icl-rocketry/Ricardo-Crosshair/Hardware/Main board.kicad_pcb

## KiCad design Hardware/Main board.kicad_pcb (2025-07-31)

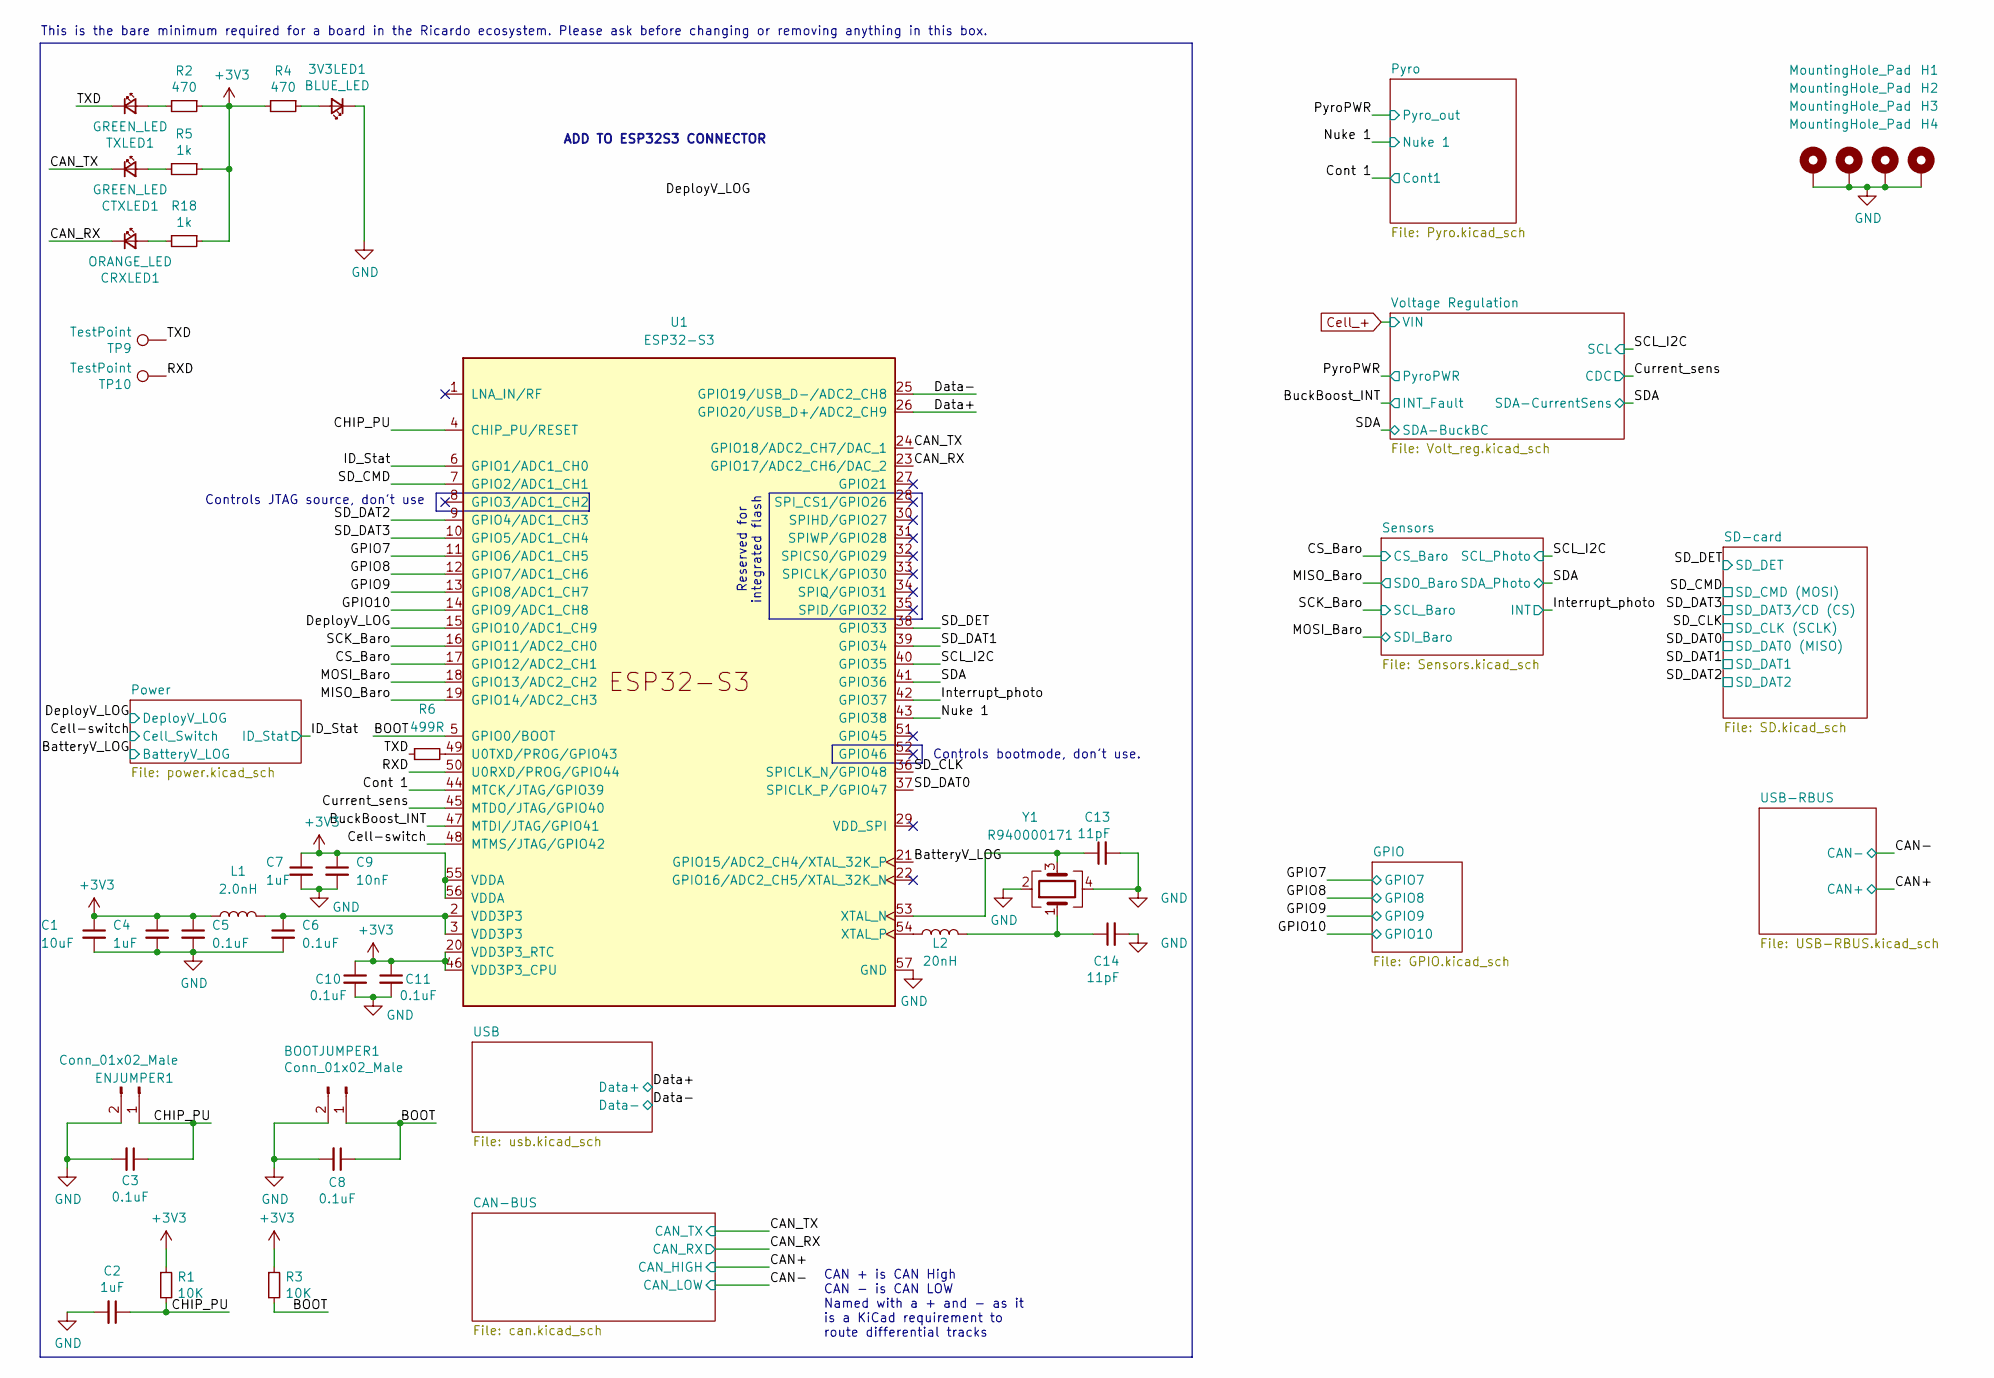
[picture p1: schematic Main board.kicad_sch]

Parts:
3V3LED1: BLUE_LED; LED_0402_1005Metric
BOOTJUMPER1: Conn_01x02_Male; PinHeader_1x02_P2.54mm_Vertical
C1: 10uF; C_0402_1005Metric
C2, C4, C7: 1uF; C_0402_1005Metric
C3, C5, C6, C8, C10, C11: 0.1uF; C_0402_1005Metric
C9: 10nF; C_0402_1005Metric
C13, C14: 11pF; C_0402_1005Metric
CRXLED1: ORANGE_LED; LED_0402_1005Metric
CTXLED1: GREEN_LED; LED_0402_1005Metric
ENJUMPER1: Conn_01x02_Male; PinHeader_1x02_P2.54mm_Vertical
H1, H2, H3, H4: MountingHole_Pad; MountingHole_3.2mm_M3_DIN965_Pad
L1: 2.0nH; L_0402_1005Metric
L2: 20nH; L_0402_1005Metric
R1, R3: 10K; R_0402_1005Metric
R2, R4: 470; R_0402_1005Metric
R5, R18: 1k; R_0402_1005Metric
R6: 499R; R_0402_1005Metric
TP9, TP10: TestPoint; TestPoint_Pad_D1.0mm
TXLED1: GREEN_LED; LED_0402_1005Metric
U1: ESP32-S3; QFN40P700X700X90-57N
Y1: R940000171; Crystal_SMD_2016-4Pin_2.0x1.6mm

Connections:
+3V3: C1.1, C4.1, C5.1, C7.1, C9.1, C10.1, C11.1, L1.1, R1.1, R2.1, R3.1, R4.2, R5.1, R18.1, U1.20 (VDD3P3_RTC), U1.46 (VDD3P3_CPU), U1.55 (VDDA), U1.56 (VDDA); also elsewhere on the board
/BOOT: BOOTJUMPER1.1, C8.1, R3.2, U1.5 (GPIO0/BOOT)
/BatteryV_LOG: U1.21 (GPIO15/ADC2_CH4/XTAL_32K_P); also elsewhere on the board
/BuckBoost_INT: U1.47 (MTDI/JTAG/GPIO41); also elsewhere on the board
/CAN_RX: CRXLED1.1 (K), U1.23 (GPIO17/ADC2_CH6/DAC_2); also elsewhere on the board
/CAN_TX: CTXLED1.1 (K), U1.24 (GPIO18/ADC2_CH7/DAC_1); also elsewhere on the board
/CHIP_PU: C2.1, C3.1, ENJUMPER1.1, R1.2, U1.4 (CHIP_PU/RESET)
/CS_Baro: U1.17 (GPIO12/ADC2_CH1); also elsewhere on the board
/Cell-switch: U1.48 (MTMS/JTAG/GPIO42); also elsewhere on the board
/Cont 1: U1.44 (MTCK/JTAG/GPIO39); also elsewhere on the board
/Current_sens: U1.45 (MTDO/JTAG/GPIO40); also elsewhere on the board
/Data+: U1.26 (GPIO20/USB_D+/ADC2_CH9); also elsewhere on the board
/Data-: U1.25 (GPIO19/USB_D-/ADC2_CH8); also elsewhere on the board
/DeployV_LOG: U1.15 (GPIO10/ADC1_CH9); also elsewhere on the board
/GPIO7: U1.11 (GPIO6/ADC1_CH5); also elsewhere on the board
/GPIO8: U1.12 (GPIO7/ADC1_CH6); also elsewhere on the board
/GPIO9: U1.13 (GPIO8/ADC1_CH7); also elsewhere on the board
/GPIO10: U1.14 (GPIO9/ADC1_CH8); also elsewhere on the board
/ID_Stat: U1.6 (GPIO1/ADC1_CH0); also elsewhere on the board
/Interrupt_photo: U1.42 (GPIO37); also elsewhere on the board
/MISO_Baro: U1.19 (GPIO14/ADC2_CH3); also elsewhere on the board
/MOSI_Baro: U1.18 (GPIO13/ADC2_CH2); also elsewhere on the board
/Nuke 1: U1.43 (GPIO38); also elsewhere on the board
/RXD: TP10.1, U1.50 (U0RXD/PROG/GPIO44)
/SCK_Baro: U1.16 (GPIO11/ADC2_CH0); also elsewhere on the board
/SCL_I2C: U1.40 (GPIO35); also elsewhere on the board
/SDA: U1.41 (GPIO36); also elsewhere on the board
/SD_CLK: U1.36 (SPICLK_N/GPIO48); also elsewhere on the board
/SD_CMD: U1.7 (GPIO2/ADC1_CH1); also elsewhere on the board
/SD_DAT0: U1.37 (SPICLK_P/GPIO47); also elsewhere on the board
/SD_DAT1: U1.39 (GPIO34); also elsewhere on the board
/SD_DAT2: U1.9 (GPIO4/ADC1_CH3); also elsewhere on the board
/SD_DAT3: U1.10 (GPIO5/ADC1_CH4); also elsewhere on the board
/SD_DET: U1.38 (GPIO33); also elsewhere on the board
/TXD: R6.1, TP9.1, TXLED1.1 (K)
GND: 3V3LED1.1 (K), BOOTJUMPER1.2, C1.2, C2.2, C3.2, C4.2, C5.2, C6.2, C7.2, C8.2, C9.2, C10.2, C11.2, C13.2, C14.2, ENJUMPER1.2, H1.1, H2.1, H3.1, H4.1, U1.57 (GND), Y1.2, Y1.4; also elsewhere on the board
unnamed: 3V3LED1.2 (A), R4.1
unnamed: C6.1, L1.2, U1.2 (VDD3P3), U1.3 (VDD3P3)
unnamed: C14.1, L2.2, Y1.1
unnamed: CRXLED1.2 (A), R18.2
unnamed: CTXLED1.2 (A), R5.2
unnamed: R2.2, TXLED1.2 (A)
unnamed: R6.2, U1.49 (U0TXD/PROG/GPIO43)
unnamed: C13.1, U1.53 (XTAL_N), Y1.3
unnamed: L2.1, U1.54 (XTAL_P)

Notes on the sheet:
Controls bootmode, don't use.
This is the bare minimum required for a board in the Ricardo ecosystem. Please ask before changing or removing anything in this box.
CAN + is CAN High CAN - is CAN LOW Named with a + and - as it is a KiCad requirement to route differential tracks
Controls JTAG source, don't use
ADD TO ESP32S3 CONNECTOR
Reserved for integrated flash

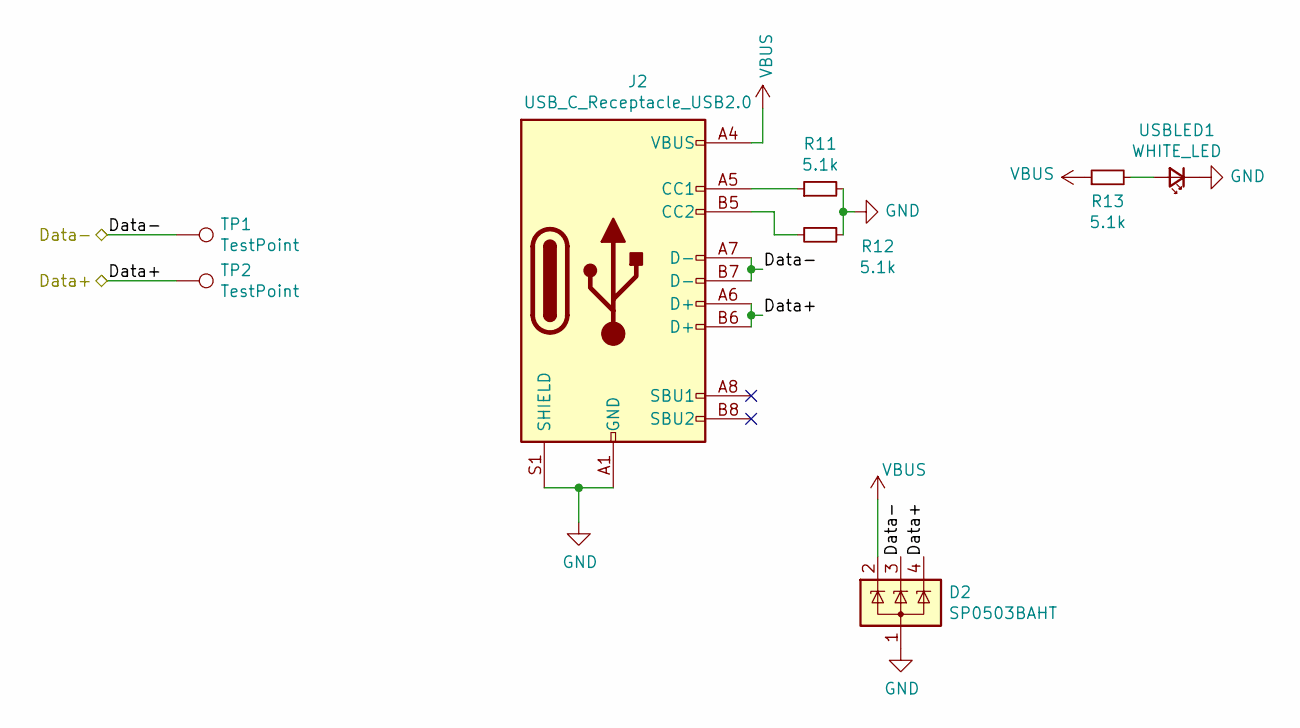
[picture p2: schematic usb.kicad_sch]

Parts:
D2: SP0503BAHT; SOT-143
J2: USB_C_Receptacle_USB2.0; USB_C_Receptacle_Palconn_UTC16-G
R11, R12, R13: 5.1k; R_0402_1005Metric
TP1, TP2: TestPoint; TestPoint_Pad_D1.0mm
USBLED1: WHITE_LED; LED_0402_1005Metric

Connections:
/Data+: D2.4 (K), J2.A6 (D+), J2.B6 (D+), TP2.1; also elsewhere on the board
/Data-: D2.3 (K), J2.A7 (D-), J2.B7 (D-), TP1.1; also elsewhere on the board
GND: D2.1 (A), J2.A1 (GND), J2.A12 (GND), J2.B1 (GND), J2.B12 (GND), J2.S1 (SHIELD), R11.2, R12.1, USBLED1.1 (K); also elsewhere on the board
unnamed: J2.A5 (CC1), R11.1
unnamed: J2.B5 (CC2), R12.2
unnamed: R13.2, USBLED1.2 (A)
VBUS: D2.2 (K), J2.A4 (VBUS), J2.A9 (VBUS), J2.B4 (VBUS), J2.B9 (VBUS), R13.1; also elsewhere on the board

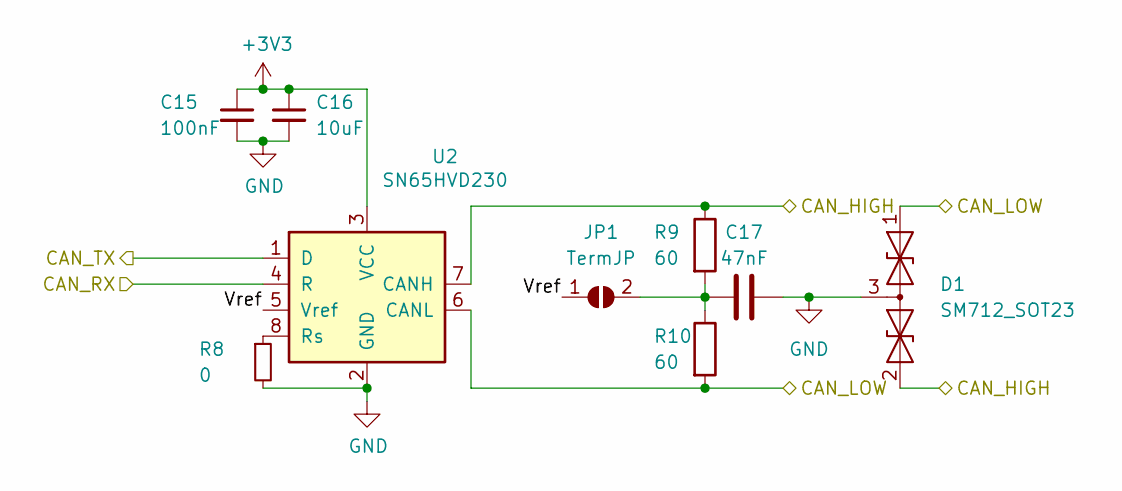
[picture p3: schematic can.kicad_sch]

Parts:
C15: 100nF; C_0402_1005Metric
C16: 10uF; C_0402_1005Metric
C17: 47nF; C_0402_1005Metric
D1: SM712_SOT23; SOT-23
JP1: TermJP; SolderJumper-2_P1.3mm_Open_RoundedPad1.0x1.5mm
R8: 0; R_0603_1608Metric
R9, R10: 60; R_0603_1608Metric
U2: SN65HVD230; SOIC-8_3.9x4.9mm_P1.27mm

Connections:
+3V3: C15.1, C16.1, U2.3 (VCC); also elsewhere on the board
/CAN+: D1.2 (A2), R9.1, U2.7 (CANH); also elsewhere on the board
/CAN-: D1.1 (A1), R10.2, U2.6 (CANL); also elsewhere on the board
/CAN-BUS/Vref: JP1.1 (A), U2.5 (Vref)
/CAN_RX: U2.4 (R); also elsewhere on the board
/CAN_TX: U2.1 (D); also elsewhere on the board
GND: C15.2, C16.2, C17.2, D1.3 (common), R8.2, U2.2 (GND); also elsewhere on the board
unnamed: C17.1, JP1.2 (B), R9.2, R10.1
unnamed: R8.1, U2.8 (Rs)

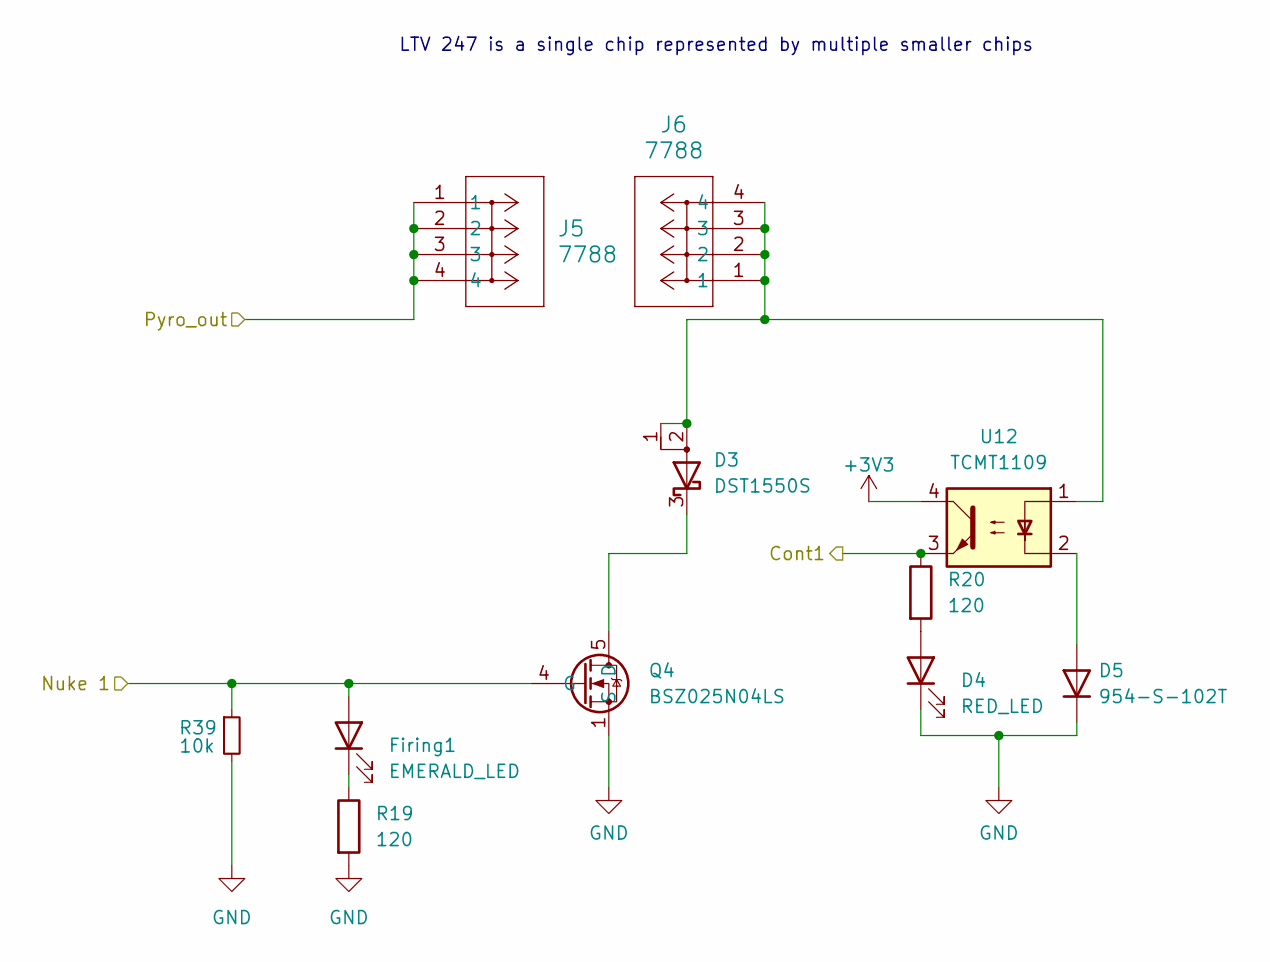
[picture p4: schematic Pyro.kicad_sch]

Parts:
D3: DST1550S; TO-277B
D4: RED_LED; LED_0603_1608Metric
D5: 954-S-102T; D_1206_3216Metric
Firing1: EMERALD_LED; LED_0402_1005Metric
J5, J6: 7788; CONN_7788_KEY
Q4: BSZ025N04LS; Manufacturer_Part_Number BSZ025N04LS; Mouser Part Number 726-BSZ025N04LS
R19: 120; R_0402_1005Metric
R20: 120; R_0603_1608Metric
R39: 10k; R_0402_1005Metric
U12: TCMT1109; SOP-4_4.4x2.6mm_P1.27mm

Connections:
+3V3: U12.4; also elsewhere on the board
/Cont 1: R20.1, U12.3; also elsewhere on the board
/Nuke 1: Firing1.2 (A), Q4.4 (G), R39.1; also elsewhere on the board
/PyroPWR: J5.1, J5.2, J5.3, J5.4; also elsewhere on the board
GND: D4.1 (K), D5.1 (K), Q4.1 (S), Q4.2 (S), Q4.3 (S), Q4.A1 (S), R19.2, R39.2; also elsewhere on the board
unnamed: D3.1 (A), D3.2 (A), J6.1, J6.2, J6.3, J6.4, U12.1
unnamed: D3.3 (K), Q4.5 (D), Q4.6 (D), Q4.7 (D), Q4.8 (D), Q4.A5 (D)
unnamed: D4.2 (A), R20.2
unnamed: D5.2 (A), U12.2
unnamed: Firing1.1 (K), R19.1

Notes on the sheet:
LTV 247 is a single chip represented by multiple smaller chips

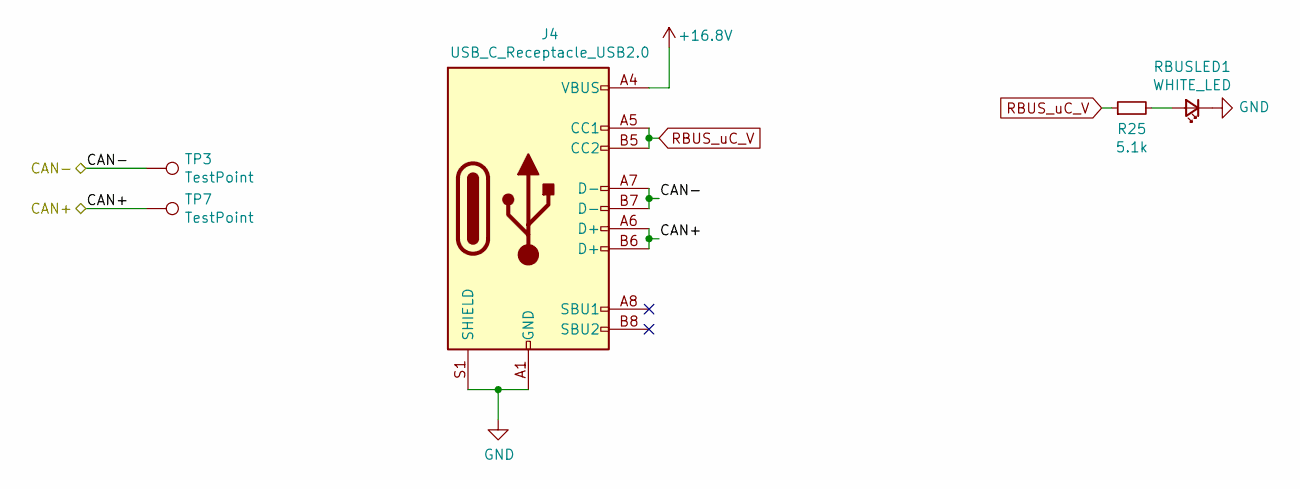
[picture p5: schematic USB-RBUS.kicad_sch]

Parts:
J4: USB_C_Receptacle_USB2.0; USB_C_Receptacle_Palconn_UTC16-G
R25: 5.1k; R_0402_1005Metric
RBUSLED1: WHITE_LED; LED_0402_1005Metric
TP3, TP7: TestPoint; TestPoint_Pad_D1.0mm

Connections:
+16.8V: J4.A4 (VBUS), J4.A9 (VBUS), J4.B4 (VBUS), J4.B9 (VBUS); also elsewhere on the board
/CAN+: J4.A6 (D+), J4.B6 (D+), TP7.1; also elsewhere on the board
/CAN-: J4.A7 (D-), J4.B7 (D-), TP3.1; also elsewhere on the board
GND: J4.A1 (GND), J4.A12 (GND), J4.B1 (GND), J4.B12 (GND), J4.S1 (SHIELD), RBUSLED1.1 (K); also elsewhere on the board
unnamed: R25.2, RBUSLED1.2 (A)
RBUS_uC_V: J4.A5 (CC1), J4.B5 (CC2), R25.1; also elsewhere on the board

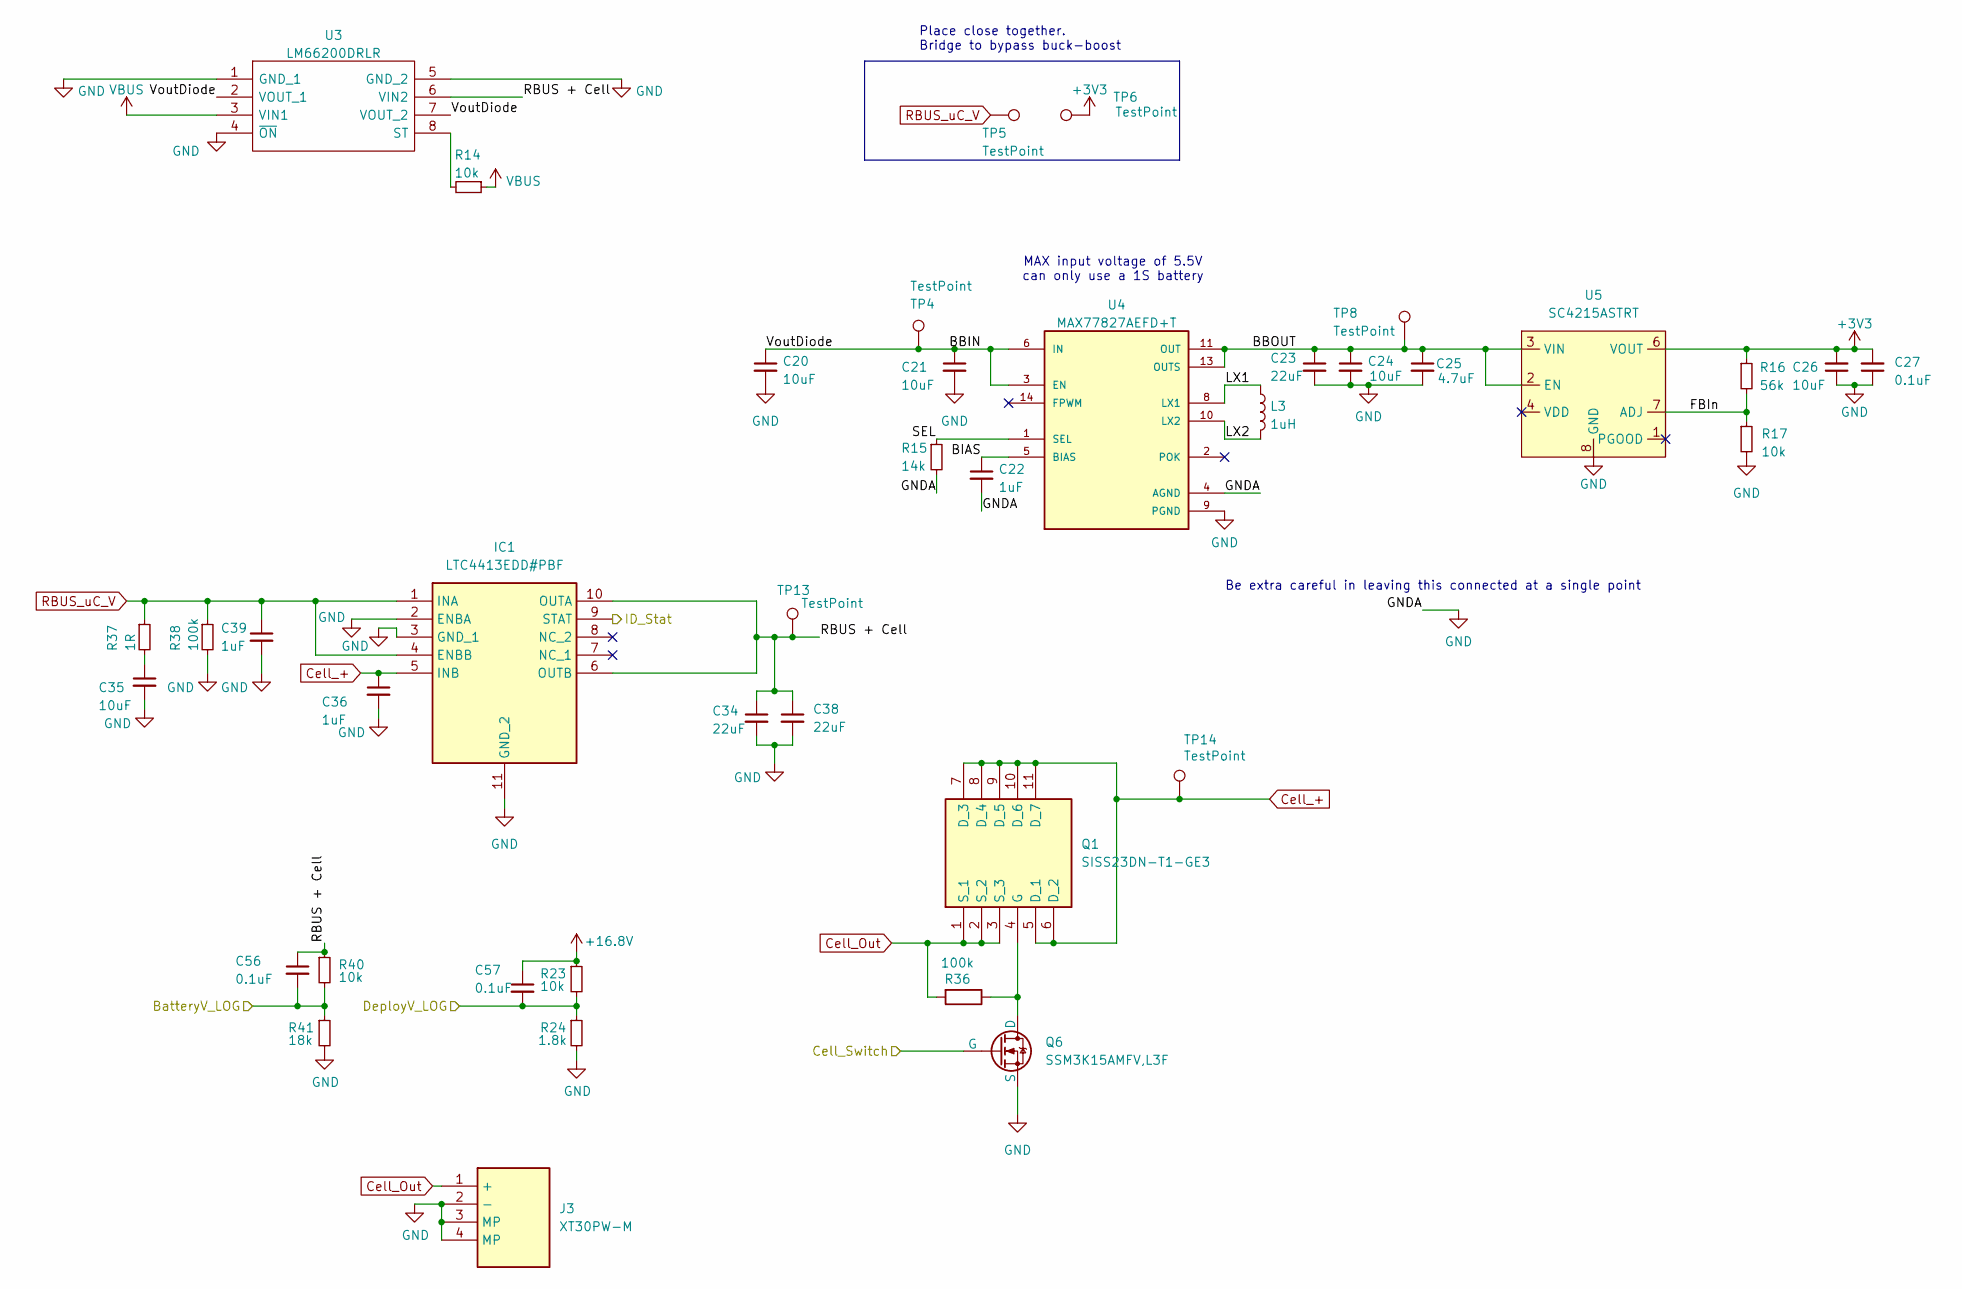
[picture p6: schematic power.kicad_sch]

Parts:
C20, C24, C26, C35: 10uF; C_0402_1005Metric
C21: 10uF; C_0603_1608Metric
C22, C36, C39: 1uF; C_0402_1005Metric
C23: 22uF; C_0603_1608Metric
C25: 4.7uF; C_0402_1005Metric
C27, C56, C57: 0.1uF; C_0402_1005Metric
C34, C38: 22uF; C_0402_1005Metric
IC1: LTC4413EDD#PBF; SON50P300X300X80-11N-D; Mouser Part Number 584-LTC4413EDD#PBF
J3: XT30PW-M; XT30PWM; Manufacturer_Part_Number XT30PW-M
L3: 1uH; L_0805_2012Metric
Q1: SISS23DN-T1-GE3; SQS850ENT1_GE3; Mouser Part Number 78-SISS23DN-T1-GE3
Q6: SSM3K15AMFV,L3F; SOT-723
R14, R17, R23, R40: 10k; R_0402_1005Metric
R15: 14k; R_0402_1005Metric
R16: 56k; R_0402_1005Metric
R24: 1.8k; R_0402_1005Metric
R36, R38: 100k; R_0402_1005Metric
R37: 1R; R_0402_1005Metric
R41: 18k; R_0402_1005Metric
TP4, TP5, TP6, TP8, TP14: TestPoint; TestPoint_Pad_D1.5mm
TP13: TestPoint; TestPoint_Pad_D1.0mm
U3: LM66200DRLR; SOTFL50P160X60-8N; Manufacturer_Part_Number LM66200DRLR; Mouser Part Number 595-LM66200DRLR
U4: MAX77827AEFD+T; CONV_MAX77827AEFD+T; PARTREV B
U5: SC4215ASTRT; SOIC127P599X175-9N

Connections:
+3V3: C26.2, C27.2, R16.1, TP6.1, U5.6 (VOUT); also elsewhere on the board
+16.8V: C57.1, R23.1; also elsewhere on the board
/BatteryV_LOG: C56.2, R40.2, R41.1; also elsewhere on the board
/Cell-switch: Q6.2 (G); also elsewhere on the board
/DeployV_LOG: C57.2, R23.2, R24.1; also elsewhere on the board
/ID_Stat: IC1.9 (STAT); also elsewhere on the board
/Power/BBIN: C20.1, C21.1, TP4.1, U3.2 (VOUT_1), U3.7 (VOUT_2), U4.3 (EN), U4.6 (IN)
/Power/BBOUT: C23.1, C24.1, C25.1, TP8.1, U4.11 (OUT), U4.13 (OUTS), U5.2 (EN), U5.3 (VIN)
/Power/BIAS: C22.1, U4.5 (BIAS)
/Power/FBIn: R16.2, R17.1, U5.7 (ADJ)
/Power/LX1: L3.1, U4.8 (LX1)
/Power/LX2: L3.2, U4.10 (LX2)
/Power/RBUS + Cell: C34.1, C38.1, C56.1, IC1.6 (OUTB), IC1.10 (OUTA), R40.1, TP13.1, U3.6 (VIN2)
/Power/SEL: R15.1, U4.1 (SEL)
Cell_+: C36.1, IC1.5 (INB), Q1.5 (D_1), Q1.6 (D_2), Q1.7 (D_3), Q1.8 (D_4), Q1.9 (D_5), Q1.10 (D_6), Q1.11 (D_7), TP14.1; also elsewhere on the board
Cell_Out: J3.1 (+), Q1.1 (S_1), Q1.2 (S_2), Q1.3 (S_3), R36.2
GND: C20.2, C21.2, C22.2, C23.2, C24.2, C25.2, C26.1, C27.1, C34.2, C35.2, C36.2, C38.2, C39.2, IC1.2 (ENBA), IC1.3 (GND_1), IC1.11 (GND_2), J3.2 (-), J3.3 (MP), J3.4 (MP), Q6.3 (S), R15.2, R17.2, R24.2, R38.2, R41.2, U3.1 (GND_1), U3.4 (~ON), U3.5 (GND_2), U4.4 (AGND), U4.9 (PGND), U5.8 (GND), U5.9 (GND); also elsewhere on the board
unnamed: C35.1, R37.2
unnamed: Q1.4 (G), Q6.1 (D), R36.1
unnamed: R14.2, U3.8 (ST)
RBUS_uC_V: C39.1, IC1.1 (INA), IC1.4 (ENBB), R37.1, R38.1, TP5.1; also elsewhere on the board
VBUS: R14.1, U3.3 (VIN1); also elsewhere on the board

Notes on the sheet:
Place close together. Bridge to bypass buck-boost
MAX input voltage of 5.5V can only use a 1S battery
Be extra careful in leaving this connected at a single point

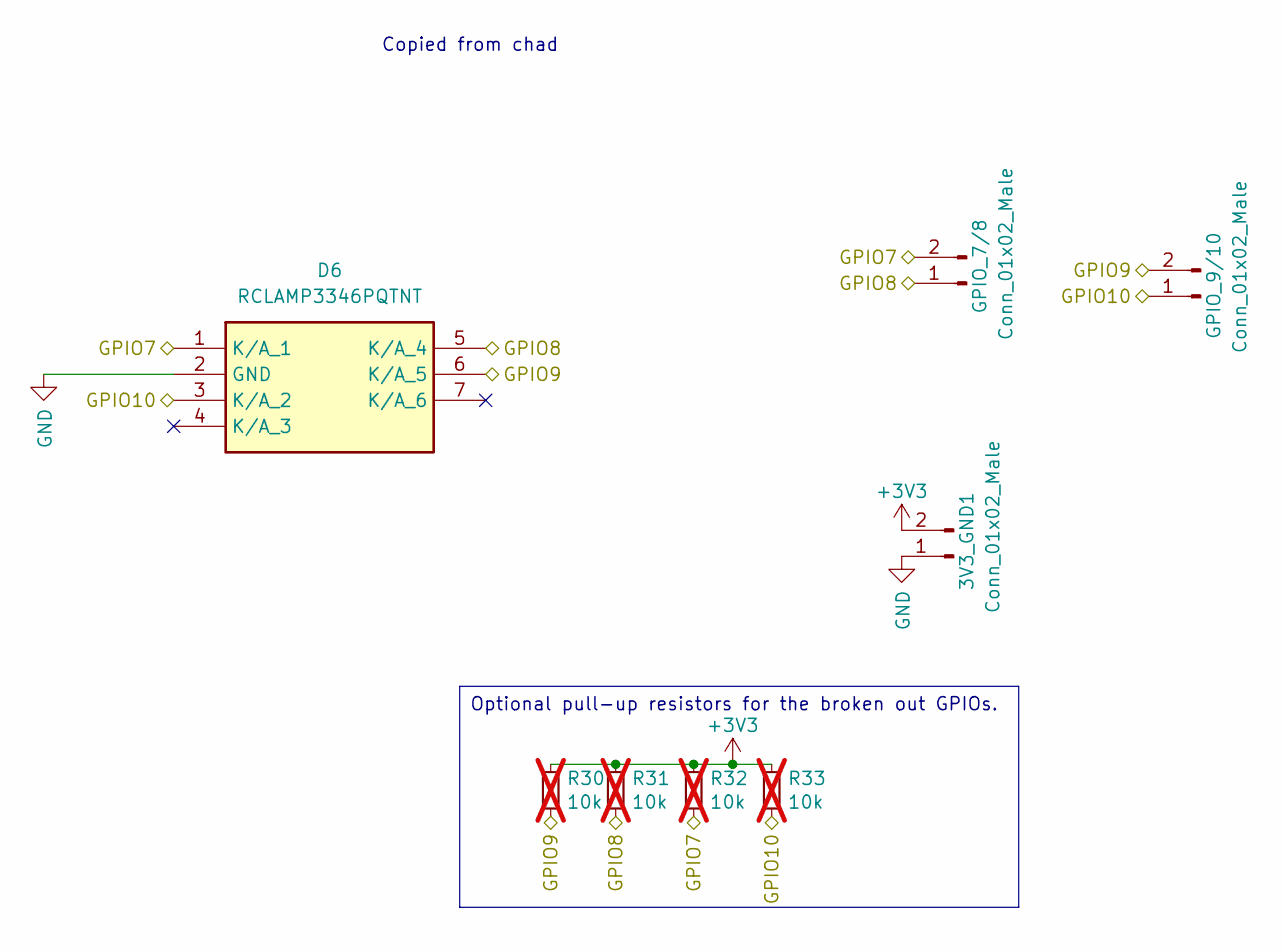
[picture p7: schematic GPIO.kicad_sch]

Parts:
3V3_GND1: Conn_01x02_Male; PinHeader_1x02_P2.54mm_Vertical
D6: RCLAMP3346PQTNT; Mouser Part Number 947-RCLAMP3346PQTNT
GPIO_7/8, GPIO_9/10: Conn_01x02_Male; PinHeader_1x02_P2.54mm_Vertical
R30, R31, R32, R33: 10k; R_0402_1005Metric; not fitted

Connections:
+3V3: 3V3_GND1.2, R30.1, R31.1, R32.1, R33.1; also elsewhere on the board
/GPIO7: D6.1 (K/A_1), GPIO_7/8.2, R32.2; also elsewhere on the board
/GPIO8: D6.5 (K/A_4), GPIO_7/8.1, R31.2; also elsewhere on the board
/GPIO9: D6.6 (K/A_5), GPIO_9/10.2, R30.2; also elsewhere on the board
/GPIO10: D6.3 (K/A_2), GPIO_9/10.1, R33.2; also elsewhere on the board
GND: 3V3_GND1.1, D6.2 (GND); also elsewhere on the board

Notes on the sheet:
Copied from chad
Optional pull-up resistors for the broken out GPIOs.

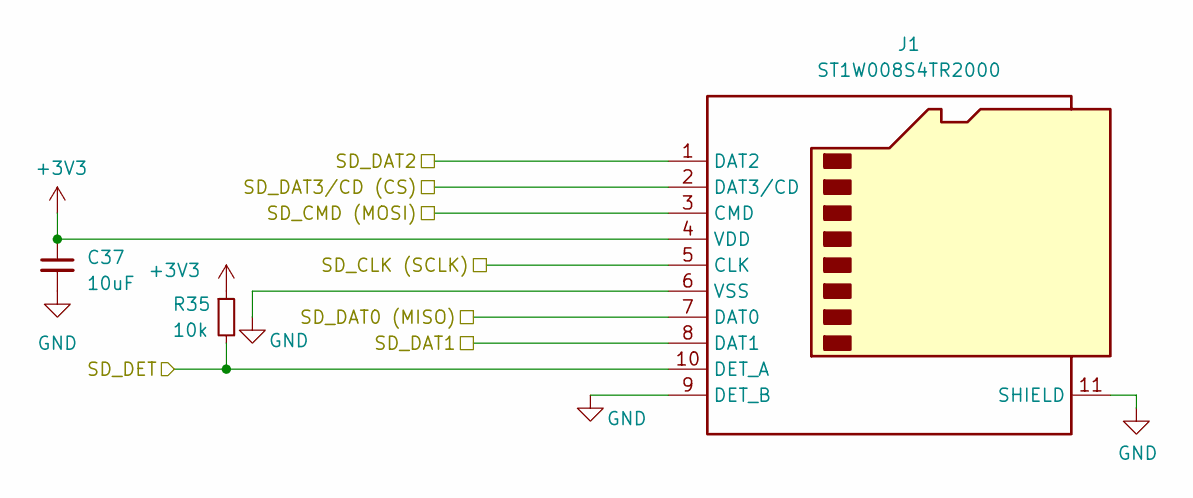
[picture p8: schematic SD.kicad_sch]

Parts:
C37: 10uF; C_0402_1005Metric
J1: ST1W008S4TR2000; microSD_HC_Hirose_DM3AT-SF-PEJM5; PARTREV 1
R35: 10k; R_0402_1005Metric

Connections:
+3V3: C37.1, J1.4 (VDD), R35.1; also elsewhere on the board
/SD_CLK: J1.5 (CLK); also elsewhere on the board
/SD_CMD: J1.3 (CMD); also elsewhere on the board
/SD_DAT0: J1.7 (DAT0); also elsewhere on the board
/SD_DAT1: J1.8 (DAT1); also elsewhere on the board
/SD_DAT2: J1.1 (DAT2); also elsewhere on the board
/SD_DAT3: J1.2 (DAT3/CD); also elsewhere on the board
/SD_DET: J1.10 (DET_A), R35.2; also elsewhere on the board
GND: C37.2, J1.6 (VSS), J1.9 (DET_B), J1.11 (SHIELD); also elsewhere on the board

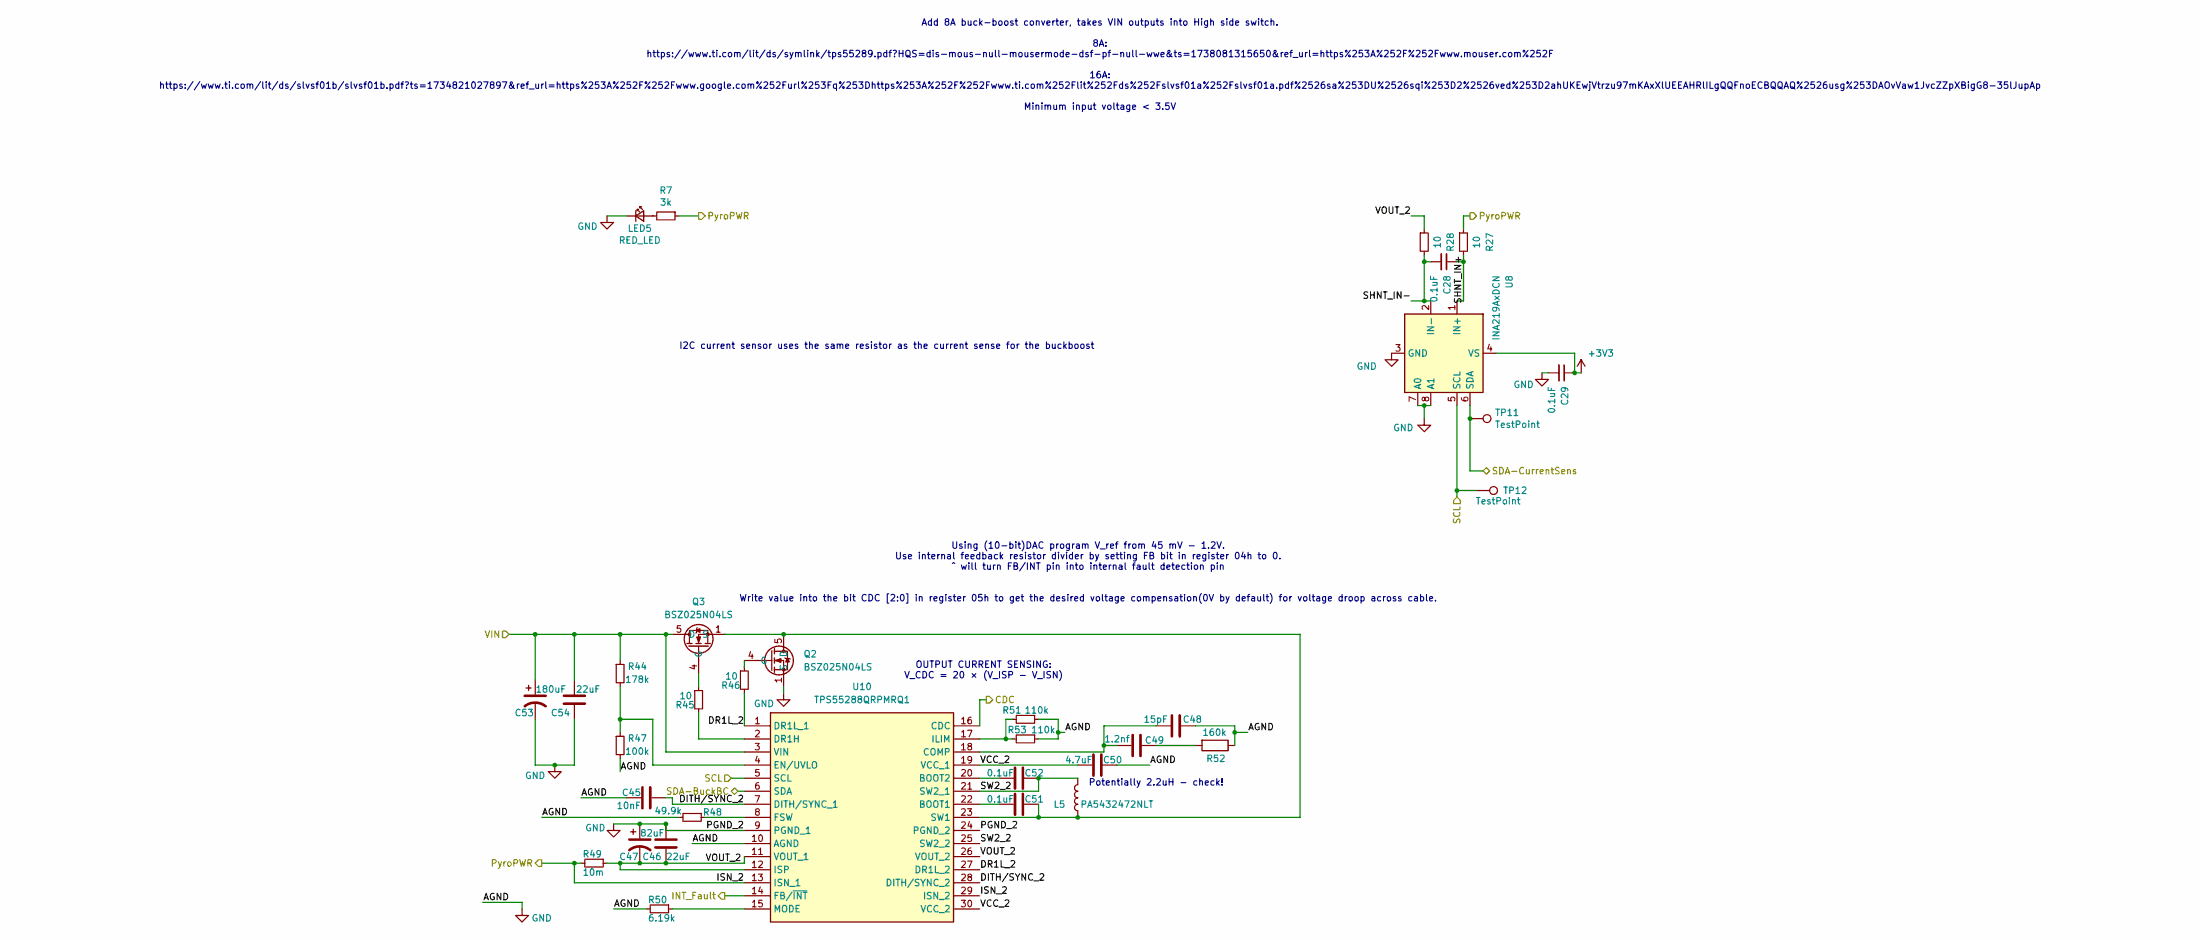
[picture p9: schematic Volt_reg.kicad_sch]

Parts:
C28, C29, C51, C52: 0.1uF; C_0402_1005Metric
C45: 10nF; C_0402_1005Metric
C46, C54: 22uF; C_0805_2012Metric
C47: 82uF; CP_EIA-6032-28_Kemet-C
C48: 15pF; C_0402_1005Metric
C49: 1.2nf; C_0402_1005Metric
C50: 4.7uF; C_0402_1005Metric
C53: 180uF; CP_EIA-7260-20_AVX-M
L5: PA5432472NLT
LED5: RED_LED; LED_0402_1005Metric
Q2, Q3: BSZ025N04LS; Manufacturer_Part_Number BSZ025N04LS; Mouser Part Number 726-BSZ025N04LS
R7: 3k; R_0402_1005Metric
R27, R28, R45, R46: 10; R_0402_1005Metric
R44: 178k; R_0402_1005Metric
R47: 100k; R_0402_1005Metric
R48: 49.9k; R_0402_1005Metric
R49: 10m; R_1206_3216Metric
R50: 6.19k; R_0402_1005Metric
R51, R53: 110k; R_0402_1005Metric
R52: 160k; R_0402_1005Metric
TP11, TP12: TestPoint; TestPoint_Pad_D1.0mm
U8: INA219AxDCN; SOT-23-8
U10: TPS55288QRPMRQ1; TPS552882QRPMRQ1; Mouser Part Number 595-TPS55288QRPMRQ1

Connections:
+3V3: C29.1, U8.4 (VS); also elsewhere on the board
/BuckBoost_INT: U10.14 (FB/~INT); also elsewhere on the board
/Current_sens: U10.16 (CDC); also elsewhere on the board
/PyroPWR: R7.1, R27.1, R49.2, U10.13 (ISN_1), U10.29 (ISN_2); also elsewhere on the board
/SCL_I2C: TP12.1, U8.5 (SCL), U10.5 (SCL); also elsewhere on the board
/SDA: TP11.1, U8.6 (SDA), U10.6 (SDA); also elsewhere on the board
/Voltage Regulation/DITH/SYNC_2: C45.1, U10.7 (DITH/SYNC_1), U10.28 (DITH/SYNC_2)
/Voltage Regulation/DR1L_2: R46.2, U10.1 (DR1L_1), U10.27 (DR1L_2)
/Voltage Regulation/SHNT_IN+: C28.1, R27.2, U8.1 (IN+)
/Voltage Regulation/SHNT_IN-: C28.2, R28.2, U8.2 (IN-)
/Voltage Regulation/SW2_2: C52.1, L5.2, U10.21 (SW2_1), U10.25 (SW2_2)
/Voltage Regulation/VCC_2: C50.2, U10.19 (VCC_1), U10.30 (VCC_2)
/Voltage Regulation/VOUT_2: C46.1, C47.2, R28.1, R49.1, U10.11 (VOUT_1), U10.12 (ISP), U10.26 (VOUT_2)
Cell_+: C53.1, C54.2, Q3.5 (D), Q3.6 (D), Q3.7 (D), Q3.8 (D), Q3.A5 (D), R44.1, U10.3 (VIN); also elsewhere on the board
GND: C29.2, C45.2, C46.2, C47.1, C48.1, C50.1, C53.2, C54.1, LED5.1 (K), Q2.1 (S), Q2.2 (S), Q2.3 (S), Q2.A1 (S), R47.2, R48.2, R50.2, R51.1, R52.1, R53.1, U8.3 (GND), U8.7 (A0), U8.8 (A1), U10.9 (PGND_1), U10.10 (AGND), U10.24 (PGND_2); also elsewhere on the board
unnamed: C49.1, R52.2
unnamed: LED5.2 (A), R7.2
unnamed: Q2.4 (G), R46.1
unnamed: Q3.4 (G), R45.1
unnamed: C51.2, U10.22 (BOOT1)
unnamed: C52.2, U10.20 (BOOT2)
unnamed: C48.2, C49.2, U10.18 (COMP)
unnamed: R45.2, U10.2 (DR1H)
unnamed: R44.2, R47.1, U10.4 (EN/UVLO)
unnamed: R48.1, U10.8 (FSW)
unnamed: R51.2, R53.2, U10.17 (ILIM)
unnamed: R50.1, U10.15 (MODE)
unnamed: C51.1, L5.1, Q2.5 (D), Q2.6 (D), Q2.7 (D), Q2.8 (D), Q2.A5 (D), Q3.1 (S), Q3.2 (S), Q3.3 (S), Q3.A1 (S), U10.23 (SW1)

Notes on the sheet:
Using (10-bit)DAC program V_ref from 45 mV - 1.2V. Use internal feedback resistor divider by setting FB bit in register 04h to 0. ^ will turn FB/INT pin into internal fault detection pin Write value into the bit CDC [2:0] in register 05h to get the desired voltage compensation(0V by default) for vo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
OUTPUT CURRENT SENSING: V_CDC = 20 × (V_ISP - V_ISN)
Add 8A buck-boost converter, takes VIN outputs into High side switch. 8A: https://www.ti.com/lit/ds/symlink/tps55289.pdf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 16A: https://www.ti.com/lit/ds/slvsf01b/slvsf01b.pdf?ts=173482102789…
Potentially 2.2uH - check!
I2C current sensor uses the same resistor as the current sense for the buckboost

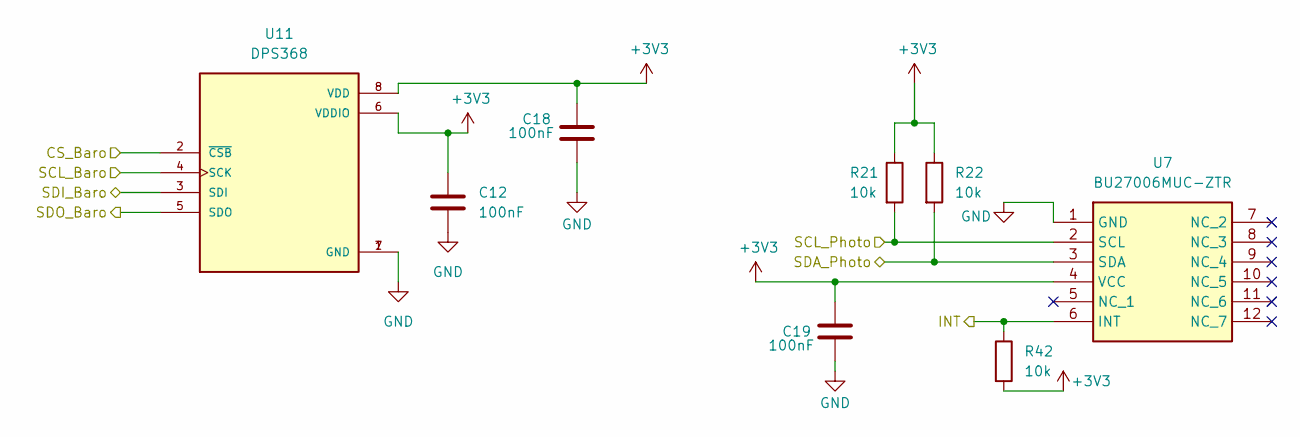
[picture p10: schematic Sensors.kicad_sch]

Parts:
C12, C18, C19: 100nF; C_0402_1005Metric
R21, R22, R42: 10k; R_0402_1005Metric
U7: BU27006MUC-ZTR; BU27006MUCZTR; Mouser Part Number 755-BU27006MUC-ZTR
U11: DPS368; XDCR_DPS310

Connections:
+3V3: C12.1, C18.1, C19.1, R21.1, R22.1, R42.2, U7.4 (VCC), U11.6 (VDDIO), U11.8 (VDD); also elsewhere on the board
/CS_Baro: U11.2 (~CSB); also elsewhere on the board
/Interrupt_photo: R42.1, U7.6 (INT); also elsewhere on the board
/MISO_Baro: U11.5 (SDO); also elsewhere on the board
/MOSI_Baro: U11.3 (SDI); also elsewhere on the board
/SCK_Baro: U11.4 (SCK); also elsewhere on the board
/SCL_I2C: R21.2, U7.2 (SCL); also elsewhere on the board
/SDA: R22.2, U7.3 (SDA); also elsewhere on the board
GND: C12.2, C18.2, C19.2, U7.1 (GND), U11.1 (GND), U11.7 (GND); also elsewhere on the board
