icl-rocketry/Ricardo-Crosshair/Hardware/Main board.kicad_pcb

## KiCad design Hardware/Main board.kicad_pcb (continued)

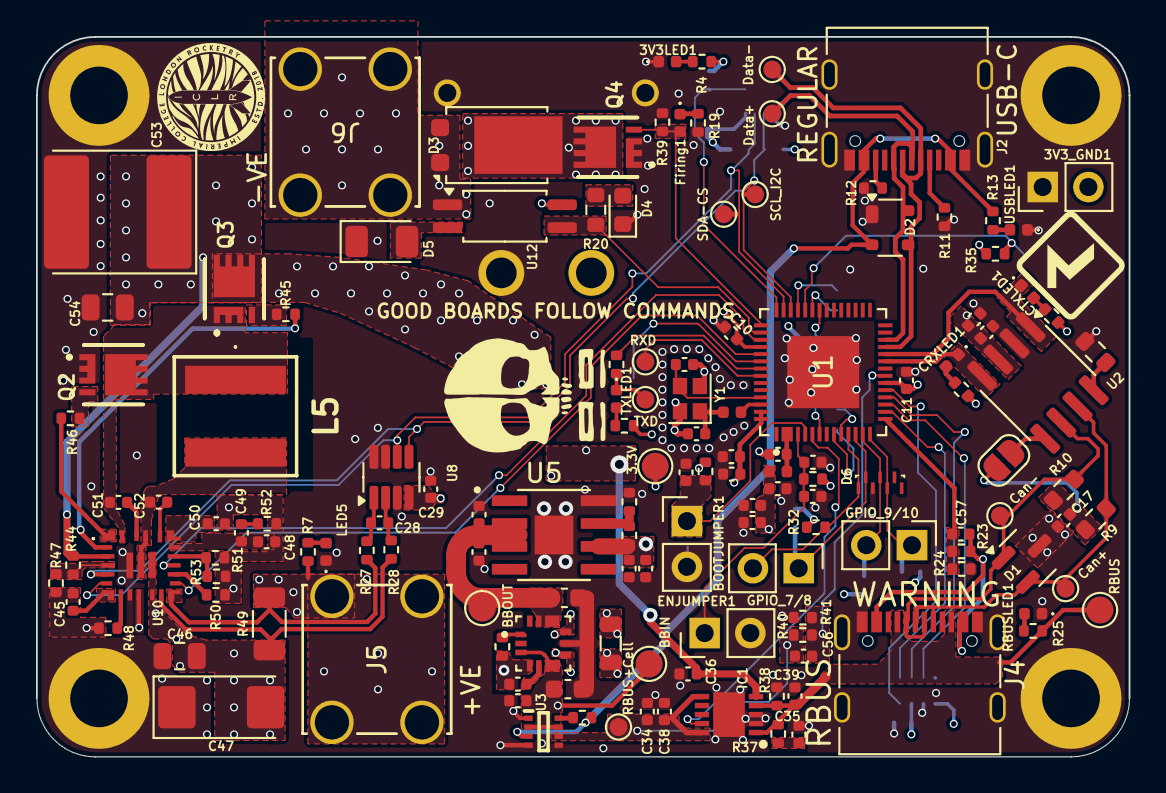
[picture p11: board Main board.kicad_pcb from above]

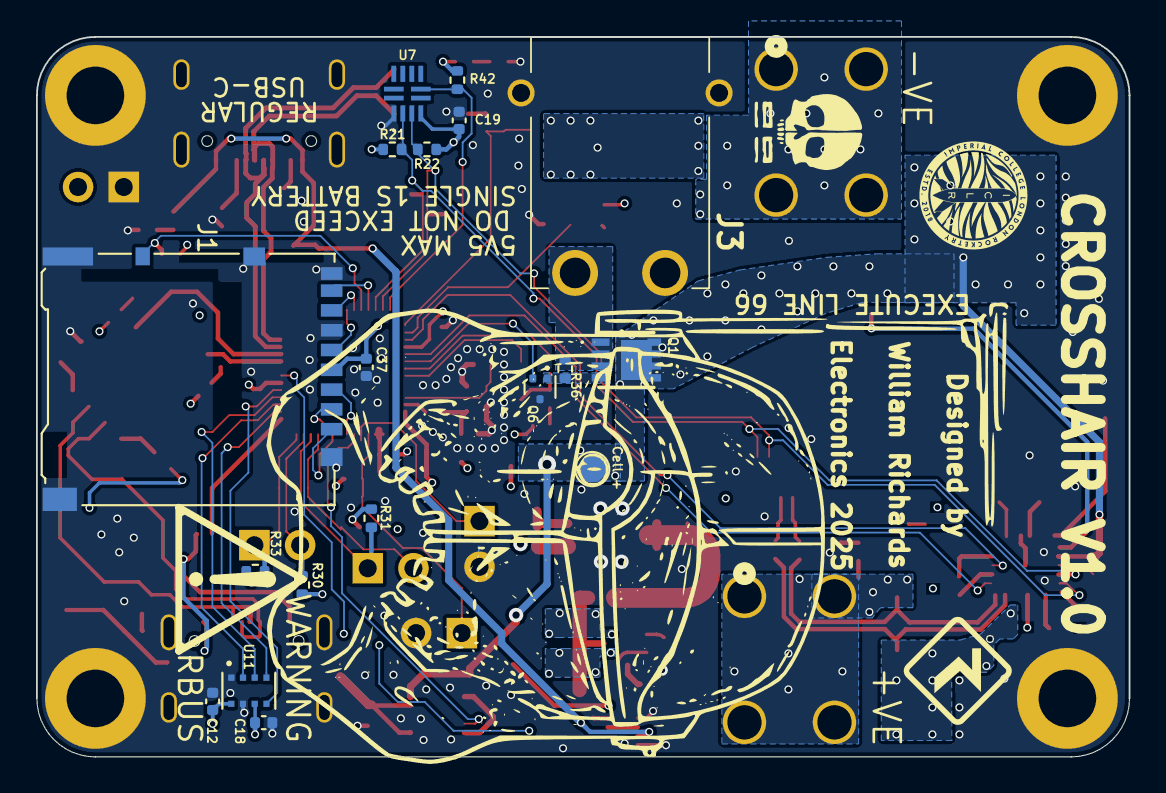
[picture p12: board Main board.kicad_pcb from below]

Board: 4 copper layers, 60.7 x 40.0 mm, 161 parts (18 on the bottom side), 96 nets.
