icl-rocketry/Ricardo-Crosshair/(commit log)

2024-11-16 Main + subsection PCB
    Created files to work on individually
    [Main board.kicad_pcb, Main board.kicad_sch, Pyro.kicad_sch, Sensors.kicad_sch, Volt_reg.kicad_sch, can.kicad_sch, power.kicad_sch, usb.kicad_sch]
2024-11-16 Change folder structure
    [Main board.kicad_pcb, Main board.kicad_sch, Pyro.kicad_sch, Sensors.kicad_sch, Volt_reg.kicad_sch, can.kicad_sch, power.kicad_sch, usb.kicad_sch]
2024-11-19 Sensor completed
    Barometer circuit done.
    [Main board.kicad_sch, Sensors.kicad_sch]
2024-11-19 Added pyro circuit
    [Main board.kicad_sch, Pyro.kicad_sch]
2024-12-07 Removed unused 'Main board' file
2024-12-07 Barometer sensor SPI
    [Main board.kicad_sch, Sensors.kicad_sch]
2025-01-21 Barometer fix + Photo sensor
    Fixed orientation of ground for barometer. Added Photo sensor + photo sensor symbol in library.
    Need to determine resistance for photo sensor circuit.
    [Main board.kicad_sch, Sensors.kicad_sch]
2025-01-28 USB-C + Voltage stuff
    [Main board.kicad_sch, Sensors.kicad_sch, USB-RBUS.kicad_sch, Volt_reg.kicad_sch]
2025-02-08 Voltage regulation done + used photo ic sensor library
    [Main board.kicad_sch, Pyro.kicad_sch, Sensors.kicad_sch, Volt_reg.kicad_sch]
2025-02-08 Added some pins
    [Main board.kicad_sch]
2025-02-16 New Buck boost converter
    + new sorted circuit, voltage regulation not finalised
    [Main board.kicad_sch, Sensors.kicad_sch, Volt_reg.kicad_sch, untitled.kicad_sch]
2025-03-01 PCB mid design
    [Main board.kicad_pcb, Main board.kicad_sch, Pyro.kicad_sch, SD.kicad_sch, Sensors.kicad_sch, USB-RBUS.kicad_sch, Volt_reg.kicad_sch, power.kicad_sch]
2025-03-03 PCB done more ish
    [Main board.kicad_pcb, Main board.kicad_sch, Volt_reg.kicad_sch]
2025-03-07 Crosshair V1.0
    New pyro connectors, silkscreen sorted, mostly connected properly + cool new name and image
    [Main board.kicad_pcb, Main board.kicad_sch, Pyro.kicad_sch, SD.kicad_sch, Sensors.kicad_sch, USB-RBUS.kicad_sch, Volt_reg.kicad_sch, can.kicad_sch]
2025-03-08 SD card fix + logos
    Changed SD card from the lock in to the push in
    [Main board.kicad_pcb, Main board.kicad_sch, SD.kicad_sch]
2025-03-18 Swapped battery & nichrome positions
    fixed crystal and other small things
    [Main board.kicad_pcb, Main board.kicad_sch, Volt_reg.kicad_sch, power.kicad_sch]
2025-03-21 Applied more review suggestions
    [Main board.kicad_pcb, power.kicad_sch]
2025-03-22 Testpoints + footprints + AGND plane
    [Main board.kicad_pcb, Volt_reg.kicad_sch, power.kicad_sch]
2025-04-01 Added MOSFET circuit to turn cell power on/off
    [Main board.kicad_pcb, Main board.kicad_sch, power.kicad_sch]
2025-04-01 Test point + Net shape change
    [Main board.kicad_pcb, power.kicad_sch]
2025-05-06 Crosshair post review 2
    Layout redesign + changes implemented. Traces not yet complete
    [Main board.kicad_pcb, Main board.kicad_sch, SD.kicad_sch, USB-RBUS.kicad_sch, Volt_reg.kicad_sch, power.kicad_sch]
2025-05-06 Traces connected + rejigging
    Most DRC errors taken care of
    [Main board.kicad_pcb, Main board.kicad_sch]
2025-05-07 Added extra vias
    [Main board.kicad_pcb]
2025-05-13 Changed fill
    [Main board.kicad_pcb]
2025-05-18 Major changes made to layout
    [Main board.kicad_pcb, Main board.kicad_sch, Volt_reg.kicad_sch]
2025-05-31 I2C 'bus' sorted
    [Main board.kicad_pcb, Main board.kicad_sch, USB-RBUS.kicad_sch]
2025-05-31 Removed voids
    [Main board.kicad_pcb]
2025-05-31 Added vias
    [Main board.kicad_pcb]
2025-06-03 Remove more voids
    [Main board.kicad_pcb]
2025-06-07 Final before buck boost converter moved
    [Main board.kicad_pcb]
2025-06-07 New-ish layout with moved buck boost converter
    [Main board.kicad_pcb]
2025-06-07 Saved changes
    [Volt_reg.kicad_sch]
2025-06-07 Did some work on the silkscreen
    [Main board.kicad_pcb]
2025-06-26 GPIO broken out + post review 4
    [GPIO.kicad_sch, Main board.kicad_pcb, Main board.kicad_sch, Pyro.kicad_sch, Volt_reg.kicad_sch, power.kicad_sch]
2025-06-26 Extra tweaks - current sense etc
    [GPIO.kicad_sch, Main board.kicad_pcb, Main board.kicad_sch]
2025-06-26 Silkscreen for gpio breakout
    [Main board.kicad_pcb]
2025-06-30 Changed mosfet + added top plane for Cell_+ and fixed silkscreen
    [Main board.kicad_pcb, Volt_reg.kicad_sch, power.kicad_sch]
2025-07-01 Changed buck boost inductor + changed planes and vias
    [Main board.kicad_pcb, Volt_reg.kicad_sch]
2025-07-07 Submodules added
    [ricpart.csv]
2025-07-08 Added voltage ref for post ideal diode
    (more firmware too)
    [Main board.kicad_pcb, Main board.kicad_sch, power.kicad_sch]
2025-07-22 Moved a 3V3 decoupling capacitor for ESP32
    [Main board.kicad_pcb]
2025-07-31 Mega commit
    Post review changes
    [GPIO.kicad_sch, Main board.kicad_pcb, Main board.kicad_sch, Pyro.kicad_sch, Sensors.kicad_sch, USB-RBUS.kicad_sch, Volt_reg.kicad_sch, power.kicad_sch]
2025-07-31 Silkscreen label
    Made sure PCB file was saved before push...
    [Main board.kicad_pcb, USB-RBUS.kicad_sch]
2025-10-06 States refresh + logic
    New states, removed un needed ones + passing in correct information into each one + pyro/default system implemented
    Need to sort pyro deployment logic
    [nrccrosshair.cpp, nrccrosshair.h]
2025-10-06 Fixed typo in pyro logic
    [nrccrosshair.cpp]
2025-11-11 Version 1: complete
    Firmware fixed by Riley at EuRoC
    [ricpartesp32.csv, ricparts3.csv]
